AdamFulford/Venolo/hardware/Venolo V2 Prototype.jpeg

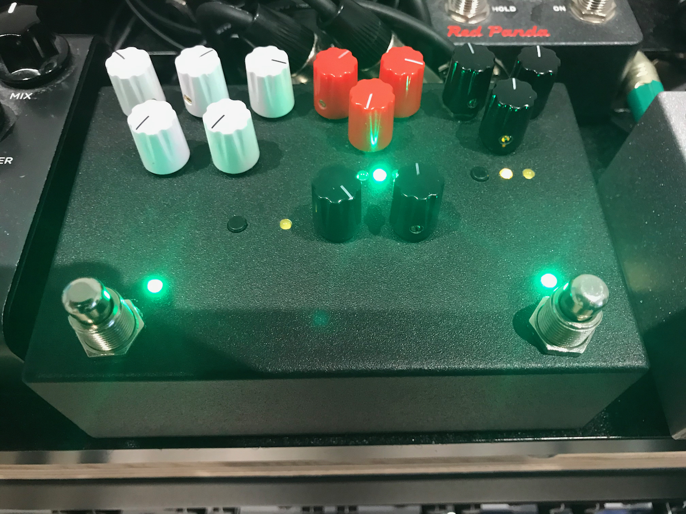
hardware/Venolo V2 Prototype.jpeg
