AdamFulford/Venolo/hardware/Venolo V2 Control Board Rev1.2.png

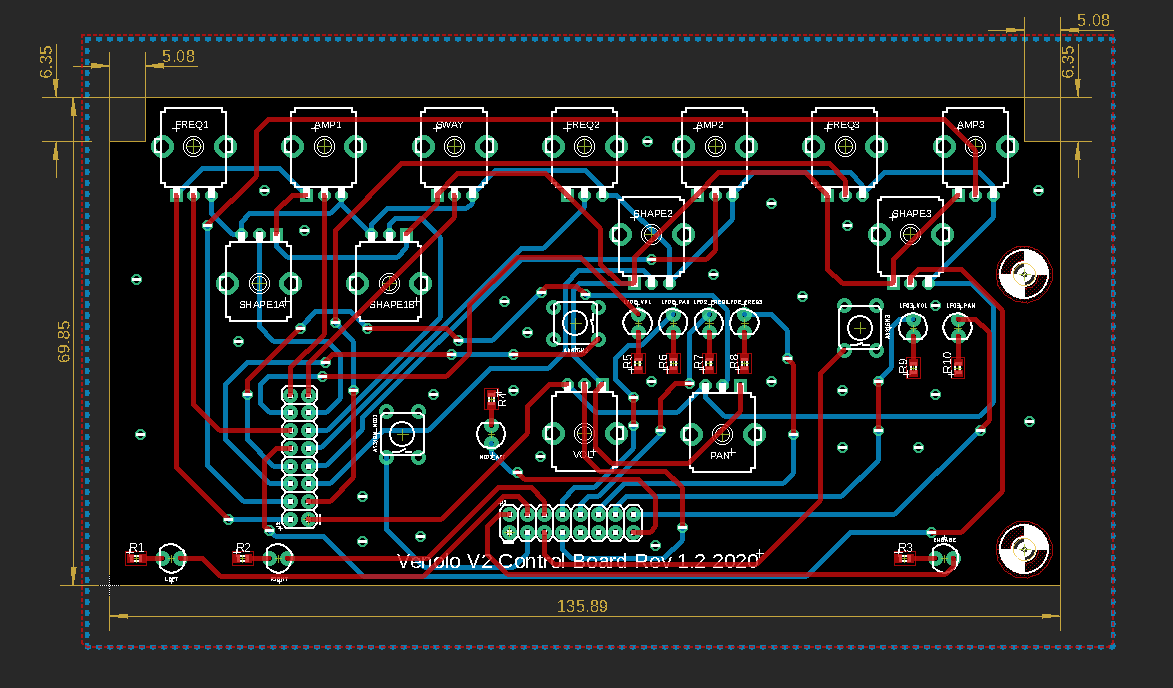
hardware/Venolo V2 Control Board Rev1.2.png
