AdamFulford/Venolo/hardware/Venolo V2 Main Board Rev1.4.png

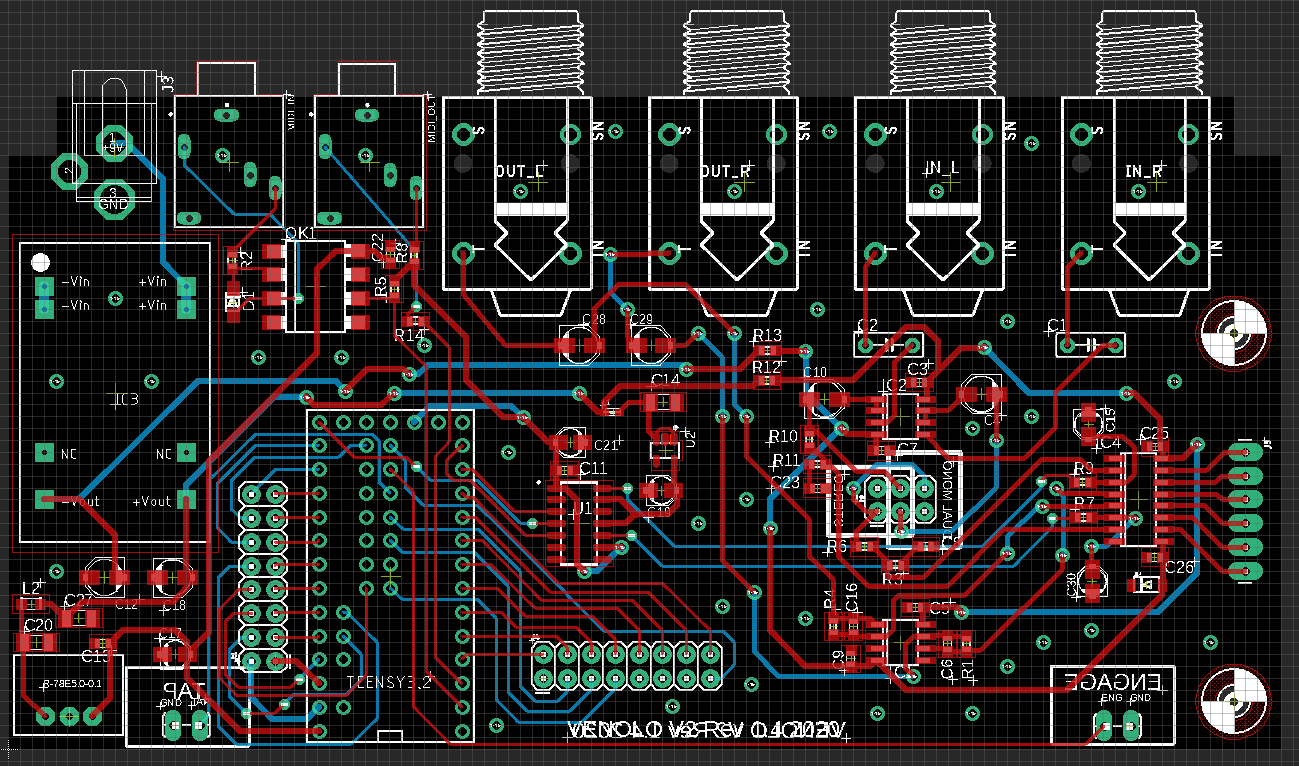
hardware/Venolo V2 Main Board Rev1.4.png
