AdamFulford/Venolo/hardware/Venolo_V2_BOM.xlsx

Main Board
Quantity | Part | Value | Device | Package | Description | Mouser
2 | C1, C2 | 0.1uF 63V | C5/2.5 | C5B2.5 | CAPACITOR | 505-MKS2C031001A00JA
2 | C12, C18 | 33u 25v | CPOL-USB | PANASONIC_B (4mm) | POLARIZED CAPACITOR, American symbol | 647-UCM1E330MCL1GS
3 | C14, C20, C27 | 22u | C-USC1206 | C1206 | CAPACITOR, American symbol | C3216X5R1E226M160AB
5 | C15, C17, C19, C21, C30 | 10u 16V | RCL_CPOL-USA | PANASONIC_A (3mm) | POLARIZED CAPACITOR, American symbol | 647-UWX1C100MCL2
9 | C3, C5, C7, C9, C11, C13, C22, C25, C26 | 100n | C-USC0603 | C0603 | CAPACITOR, American symbol | 603-CC603JRX7R8BB104
4 | C4, C10, C28, C29 | 10u 35V | CPOL-USB | PANASONIC_B (4mm) | POLARIZED CAPACITOR, American symbol | 647-UCD1V100MCL6GS
2 | C6, C16 | 100p | C-USC0603 | C0603 | CAPACITOR, American symbol | 80-C0603C101J5G3190
2 | C8, C23 | 1200p | C-USC0603 | C0603 | CAPACITOR, American symbol | 81-GCM1885C1H122JA6D
1 | D1 | 1N4148 | DIODE_DIODE-SOD323-W | DIODE_SOD323-W | DIODE | 78-1N4148WS-E3-08
1 | D2 | SM5817 | DIODE_SOD-123FL | SOD-123FL | Diode | SM5817PL-TP
2 | IC1, IC2 | OPA1652AIDR | OPA1652AIDR | LINEAR_SO08 | OP AMP | 595-OPA1652AIDR
1 | IC3 | TEL-5-1222 | TEL_5_SERIES | TEL_5_SERIES | TRACO POWER DC/DC converter TEL 5 Series | 495-TEL-5-1222
1 | IC4 | SSI2164 | SSM2164_SSM2164S | SSI2164_SOIC16N | Quad VCA chip | From Thonk/Modular Addict | https://modularaddict.com/ssi-ssi2164
1 | IC5 | LD2981ABU33 | LD2981ABU33 | OG-VREG_SOT89 | 3.3v voltage regulator | 511-LD2981ABM30 | Needs to be less than 3.3v: 2.5V - 3.0v should be ok
4 | IN_L, IN_R, OUT_L, OUT_R | OG-NEUTRIK_MONOSWSLIM | OG-NEUTRIK_MONOSWSLIM | OG-NEUTRIK_NRJ4HF | 1/4" input jacks | 550-10284 | 502-112AX | (Offboard alternative)
2 | J1, J4 | female header | CONN_08X2_HEADER | 2X8 | Tall female header
1 | J2 | male header | CONN_03X22X3_SILK_MALE_PTH | 2X3 | Short male header
1 | J3 | Kobiconn 2mm DC jack | CON-JACK2_JACK-PLUG2 | CON-JACK2_SPC4078_BIG_HOLES | DC POWER JACK | 163-7620E-E
2 | JUMP1 | Header Shunt | Header Shunt |  | MONO/STEREO Header SHUNT | 151-8010-E
1 | L1 | 1Kohm Impedance | WUERTH-ELEKTRONIK_WE-CBF_0603 | WUERTH-ELEKTRONIK_0603 | SMD EMI Suppression Ferrite Beads | 710-742792662
1 | L2 | 33uH | L-USL2012C | L2012C | INDUCTOR, American symbol | 810-MLZ2012M330WT000
2 | MIDI_IN, MIDI_OUT | 35RAPC4BH3 | 35RAPC4BH3 | SWITCHCRAFT_35RAPC4BH3 | Conn 3.5MM Stereo Jack F 5 POS Solder RA Thru-Hole 5 Terminal 1 Port | 502-35RAPC4BH3
4 | NUTS | BLACK PLASTIC NUTS |  |  |  | 550-1005
1 | OK1 | 6N138S | 6N138S | DIL8-SMD | darlington optocoupler | 859-6N138S
2 | R1, R4 | 30K | R-US_R0603 | R0603 | RESISTOR, American symbol | 652-CR0603FX-3002ELF | alternative: 47K to boost maximum gain to 6.6dB
1 | R2 | 220R | R-US_R0603 | R0603 | RESISTOR, American symbol | 652-CR0603FX-2200ELF
2 | R3, R11 | 270R | R-US_R0603 | R0603 | RESISTOR, American symbol | 652-CR0603FX-2700ELF
1 | R5 | 470R | R-US_R0603 | R0603 | RESISTOR, American symbol | 652-CR0603FX-4700ELF
2 | R6, R10 | 22k | R-US_R0603 | R0603 | RESISTOR, American symbol | 652-CR0603FX-2202ELF
4 | R7, R9, R12, R13 | 100R | R-US_R0603 | R0603 | RESISTOR, American symbol | 652-CR0603FX-1000ELF
2 | R8, R14 | 47R | R-US_R0603 | R0603 | RESISTOR, American symbol | 652-CR0603FX-47R0ELF
1 | RECOM | R-78E5.0-0.5 | 5v regulator | OG-VREG_WE78 |  | 919-R-78E5.0-0.5
1 | TEENSY3.2 | TEENSY_3.1-3.2_ALL_PINS&PADS | TEENSY_3.1-3.2_ALL_PINS&PADS | TEENSY_3.0-3.2_ALL_PINS_&_PADS | Teensy 3.2 microcontroller | 474-DEV-13736
2 | 90deg terminal pins for Teensy pads | 2 x 7 |  |  | 90 degree pins for all teensy pads
4 | inline vertical pins | 1 x 12, 1x6, 1x3 |  |  | inline vertical pins for all teensy pins
1 | U1 | MCP4922-E/SL | MCP4922-E/SL | SOIC127P600X175-14N | 12bit 2 Channel DAC | 579-MCP4922-E/SL
2 | ENGAGE SW, TAP SW |  |  |  | Soft touch momentary footswich SPST NO | From Next Gen Guitars or similar | https://nextgenguitars.ca/products/footswitch-spst-soft-off-on-momentary-solder.html
Control Board
Quantity | Part | Value | Device | Package | Description | Mouser
13 | AMP1, AMP2, AMP3, FREQ1, FREQ2, FREQ3, PAN, SHAPE1A, SHAPE1B, SHAPE2, SHAPE3, SWAY, VOL | B10K | 9MM_SNAP-IN_POT_ | 9MM_SNAP-IN_POT | 9mm vertical snap-in pot, Alpha / Panasonic style | From Thonk/Modular Addict | https://modularaddict.com/parts/potentiometers-1/9mm-potentiometers |  | https://synthcube.com/cart/alpha-9mm-potentiometer-right-angle-pcb-mount-6-35mm-round-shaft
2 | J2, J3 | male header | CONN_08X2_HEADER | 2X8 | Tall male header
7 | ENGAGE, LEFT, RIGHT, LFO2_VOL, LFO2_PAN, LFO2_FREQ1, LFO2_FREQ2 | LED GREEN | LED3MM | LED_3MM | LED (Generic)
3 | LFO_VOL, LFO3_PAN, MIDI_ACT | LED YELLOW | LED3MM | LED_3MM | LED (Generic)
3 | ASSIGN2, ASSIGN3, ASSIGN_MIDI | MOMENTARY-SWITCH-SPST-PTH-6.0MM | MOMENTARY-SWITCH-SPST-PTH-6.0MM | TACTILE_SWITCH_PTH_6.0MM | Momentary Switch (Pushbutton) - SPST | 612-1105SPF160Q1SBLK
3 | switch caps | Wurth Elektronik - 714651010100 |  |  | switch cap, black | 612-1R-BK
10 | R1 - R10 | Current Limiting Resistor (270R) | R-US_R0603 | R0603 | RESISTOR, American symbol | 652-CR0603FX-2700ELF
Hardware etc
2 | M3 screws
2 | M3 threaded spacers |  |  |  |  | 15mm spacer height to fit onboard jacks
2 | M3 nuts
13 | knobs for pots |  |  |  |  | From Thonk/Modular Addict | https://modularaddict.com/parts/knobs/davies-1900-clone-knobs
1 |  | 1590JBK |  |  | Diecast enclosure, black powder coat | 546-1590JBK
