AdamFulford/Venolo/software/pin_assignments.h

#ifndef PIN_ASSIGNMENTS_H
#define PIN_ASSIGNMENTS_H

//pin assignments
constexpr int engage_LED = 2;
//int midi_LED = 3;
constexpr int PWM_L = 3;
constexpr int PWM_R = 4;
constexpr int midi_LED = 28;
constexpr int LFO2Vol_LED = 29;
constexpr int LFO2Pan_LED = 5;
constexpr int LFO2freq1_LED = 6;
constexpr int LFO2freq3_LED = 7;
constexpr int LFO3Vol_LED = 8;
constexpr int LFO3Pan_LED = 9;
constexpr int SPI_CS = 10;
constexpr int freq1_pot = 14;
constexpr int amp1_pot = 15;
constexpr int sway_pot = 16;
constexpr int shape1a_pot = A3;
constexpr int shape1b_pot = A4;
constexpr int freq2_pot = 19;
constexpr int amp2_pot = 20;
constexpr int shape2_pot = 21;
constexpr int freq3_pot = 22;
constexpr int amp3_pot = A10;
constexpr int shape3_pot = A11;
constexpr int vol_pot = A12;
constexpr int pan_pot = A13;
constexpr int assign2_sw = 23;
constexpr int assign3_sw = 24;
constexpr int assign_midi_sw = 25;
constexpr int engage_sw = 27;
constexpr int tap_sw = 26;

#endif
