AdamFulford/Venolo/software/constants.h

#ifndef CONSTANTS_H
#define CONSTANTS_H
 
// define your own namespace to hold constants
namespace constants
{
//program tuning

constexpr uint8_t freq1Tolerance{10};//adjust this to increase/decrease stability of frequency measurement CONSTANT
constexpr uint8_t freq2Tolerance{5};//adjust this to increase/decrease stability of frequency measurement CONSTANT
constexpr uint8_t freq3Tolerance{5};//adjust this to increase/decrease stability of frequency measurement
constexpr uint8_t swayTolerance{5}; // CONSTANT
constexpr uint8_t amp1Tolerance{5};//adjust this to increase/decrease stability of Volume measurement CONSTANT
constexpr uint8_t amp2Tolerance{5};//adjust this to increase/decrease stability of Volume measurement CONSTANT
constexpr uint8_t amp3Tolerance{5};//adjust this to increase/decrease stability of Volume measurement CONSTANT
constexpr uint8_t vol_manTolerance{2}; //CONSTANT
constexpr uint8_t pan_manTolerance{4}; //CONSTANT
constexpr uint8_t shapeTolerance{2};
constexpr int midiPotTol{20};
constexpr float tap_tolerance{1.25}; //CONSTANT


//constants scaling 10bit inputs
constexpr int in_min{0}; //CONSTANT
constexpr int in_max{1023}; //CONSTANT

constexpr int DAC_min{0};
constexpr int DAC_max{4095};
constexpr int DAC_min_out{0};
constexpr int DAC_max_out{2500};

constexpr int bypass_level{290};

constexpr int PWM_min{0};
constexpr int PWM_max{250};

constexpr int numReadings{1}; //CONSTANT - smoothing amount - need to check this is working somehow
constexpr int wait{10};  //button debounce wait time
constexpr int shiftWait{500}; //wait before engaging shift function

constexpr long samplerate{10000};  //1500Hz
constexpr int interruptPeriod{(1.0/samplerate) * 1.0E6};  //in milliseconds
constexpr int waveLength{1728};  //number of steps in each wavetable (16000)

//non-lin scaling constants
constexpr float a_amp{0.8}; //CONSTANT a, amplitude pot scaling, Vol assignment (0.2)
constexpr float b_amp{0.4};  //CONSTANT b, amplitude pot scaling, vol assignment (0.6)

constexpr float a_lin{0.5}; //CONSTANT a, linear
constexpr float b_lin{0.5}; //CONSTANT b, linear

constexpr float a_freq{0.7};  //CONSTANT a, frequency pot scaling
constexpr float b_freq{0.2};  //CONSTANT a, frequency pot scaling

//Output Ranges

constexpr float freq1_min{0.1};   //min LFO freq 
constexpr float freq1_max{15.0}; //max LFO freq 
constexpr float freq2_min{0.02};
constexpr float freq2_max{7.5};
constexpr float freq3_min{0.02};
constexpr float freq3_max{7.5};

constexpr float sway_min{0.05};   //min sway value CONSTANT
constexpr float sway_max{0.95}; //max sway value CONSTANT

constexpr int max_tap{1000.0 / freq1_min}; //in milliseconds CONSTANT
constexpr int min_tap{1000.0 / freq1_max}; //CONSTANT

//waveshapes:

constexpr int numShapes{6};

/*
constexpr uint16_t sine[waveLength] PROGMEM = {0,0,1,1,2,4,6,8,10,13,16,19,22,26,30,35,40,45,50,56,62,68,75,82,89,96,104,112,121,129,138,148,157,167,177,187,198,209,220,232,244,256,268,281,294,307,320,334,348,362,376,391,406,421,437,452,468,484,501,518,534,551,569,586,604,622,640,659,677,696,715,735,754,774,794,814,834,854,875,896,917,938,959,980,1002,1024,1046,1068,1090,1112,1135,1158,1180,1203,1226,1249,1273,1296,1320,1343,1367,1391,1415,1439,1463,1487,1511,1536,1560,1585,1609,1634,1659,1684,1709,1733,1758,1783,1808,1833,1859,1884,1909,1934,1959,1984,2010,2035,2060,2085,2111,2136,2161,2186,2211,2236,2262,2287,2312,2337,2362,2386,2411,2436,2461,2486,2510,2535,2559,2584,2608,2632,2656,2680,2704,2728,2752,2775,2799,2822,2846,2869,2892,2915,2937,2960,2983,3005,3027,3049,3071,3093,3115,3136,3157,3178,3199,3220,3241,3261,3281,3301,3321,3341,3360,3380,3399,3418,3436,3455,3473,3491,3509,3526,3544,3561,3577,3594,3611,3627,3643,3658,3674,3689,3704,3719,3733,3747,3761,3775,3788,3801,3814,3827,3839,3851,3863,3875,3886,3897,3908,3918,3928,3938,3947,3957,3966,3974,3983,3991,3999,4006,4013,4020,4027,4033,4039,4045,4050,4055,4060,4065,4069,4073,4076,4079,4082,4085,4087,4089,4091,4093,4094,4094,4095,4095,};
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
5,4095,4095,4095,4095,4095,4095,4095,4095,4095,4095,4095,4095,4095,4095,4095,4095,4095,4095,4095,};
constexpr uint16_t qtr_sine_upr[waveLength] PROGMEM = {0,4,7,11,15,19,22,26,30,34,37,41,45,48,52,56,60,63,67,71,74,78,82,86,89,93,97,101,104,108,112,115,119,123,127,130,134,138,142,145,149,153,156,160,164,168,171,175,179,182,186,190,194,197,201,205,208,212,216,220,223,227,231,235,238,242,246,249,253,257,261,264,268,272,275,279,283,287,290,294,298,301,305,309,313,316,320,324,327,331,335,339,342,346,350,353,357,361,365,368,372,376,379,383,387,390,394,398,402,405,409,413,416,420,424,428,431,435,439,442,446,450,453,457,461,465,468,472,476,479,483,487,490,494,498,502,505,509,513,516,520,524,527,531,535,539,542,546,550,553,557,561,564,568,572,575,579,583,586,590,594,598,601,605,609,612,616,620,623,627,631,634,638,642,645,649,653,656,660,664,667,671,675,678,682,686,689,693,697,700,704,708,711,715,719,722,726,730,733,737,741,744,748,752,755,759,763,766,770,774,777,781,785,788,792,796,799,803,807,810,814,818,821,825,829,832,836,839,843,847,850,854,858,861,865,869,872,876,880,883,887,890,894,898,901,905,909,912,916,920,923,927,930,934,938,941,945,949,952,956,959,963,967,970,974,977,981,985,988,992,996,999,1003,1006,1010,1014,1017,1021,1024,1028,1032,1035,1039,1042,1046,1050,1053,1057,1060,1064,1068,1071,1075,1078,1082,1086,1089,1093,1096,1100,1104,1107,1111,1114,1118,1121,1125,1129,1132,1136,1139,1143,1147,1150,1154,1157,1161,1164,1168,1172,1175,1179,1182,1186,1189,1193,1197,1200,1204,1207,1211,1214,1218,1221,1225,1229,1232,1236,1239,1243,1246,1250,1253,1257,1260,1264,1268,1271,1275,12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
constexpr int swayUpDivs[numSwaySettings]   = {1,  1,  1,  1,  1,  2,  1,  2,  6,  };

constexpr int swayDwnMults[numSwaySettings] = {19, 7,  4,  9,  6,  9,  12, 24, 60, };
constexpr int swayDwnDivs[numSwaySettings]  = {6,  2,  1,  2,  1,  1,  1,  1,  1,  };

}
#endif
