AdamFulford/Venolo/software/tap_tempo.cpp

  #include "tap_tempo.h"
    
    void tap_tempo()  //called when either tap button pressed or midi tap input received
{
    static unsigned long tap_length{}; 
    static unsigned long last_time{};
    static unsigned long last_tap_length{};
    static bool tap_flag{};

    tap_length = millis() - last_time;  //tap_length is difference between current and last time

    if (constants::min_tap <= tap_length && tap_length <= constants::max_tap){
      float freq1scaled{};
      //float freq2scaled{};
      //float freq3scaled{};
      if (tap_flag){ //flag set - one previous tap registered, this is the second tap
        tap_flag = false; //reset flag
        
        //re-calculate values for DACupdate()
        freq1scaled = tapSpeed / (tap_length/1000.0);

         if(freqMode ==0){
           //reset LFO1 to peak and direction to down
          resetPhase();
          updatefreq1(freq1scaled);
         }
       

         else if(freqMode == 1){
          //reset all LFOs to peak and direction to down
          resetPhase();
          updatefreq1Mode1(freq1scaled);
        }

        last_tap_length = tap_length;

      }
      else{ //flag not set
        
        //if tap_length greater than tolerance then set tap_flag (to say this is first tap) and reset LFO (but do not change tempo)
        if(tap_length >= (constants::tap_tolerance * last_tap_length)){  
          tap_flag = true;
          resetPhase();
        }
        else{
          //re-calculate values for DACupdate()
          freq1scaled = tapSpeed / (tap_length/1000.0);
          
        if(freqMode == 0)
        {
          resetPhase();
          updatefreq1(freq1scaled);
        }
        
        else if(freqMode ==1)
        {
          resetPhase();
          updatefreq1Mode1(freq1scaled);
        }
        //update last_tap_length
        last_tap_length = tap_length;

        }

      }
    }
     //if tap length too long then set tap_flag (to say this is first tap) and reset LFO
    else if (tap_length > constants::max_tap){
      tap_flag = true;
      resetPhase();
    }
    //ignore if tap time too short
    else if (tap_length < constants::min_tap){  
      //do nothing
    }

    last_time = millis();   //always update last time
    }
